hansrune/KiCad-lib-ESP32/README.md

# KiCad-lib-ESP32
KiCad library for ESP32 PCBs
