hansrune/KiCad-lib-ESP32/3D/XIAO-ESP32-mod.step

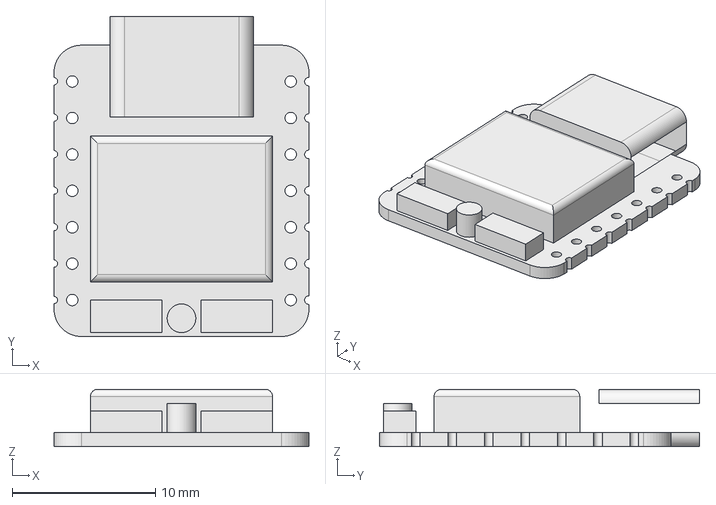
[picture p3: CAD file, 2024-09-19]
3D/XIAO-ESP32-mod.step
17.8 x 22.3 x 4.00 mm
