hansrune/KiCad-lib-ESP32/3D/XIAO_ESP32C3.step

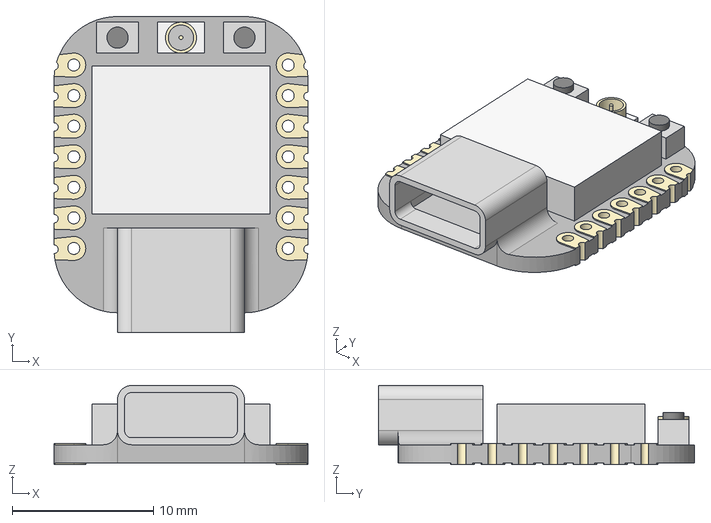
[picture p4: CAD file, 2024-06-03]
3D/XIAO_ESP32C3.step
18.0 x 22.4 x 5.60 mm
