hansrune/KiCad-lib-ESP32/3D/DCDC_01.step

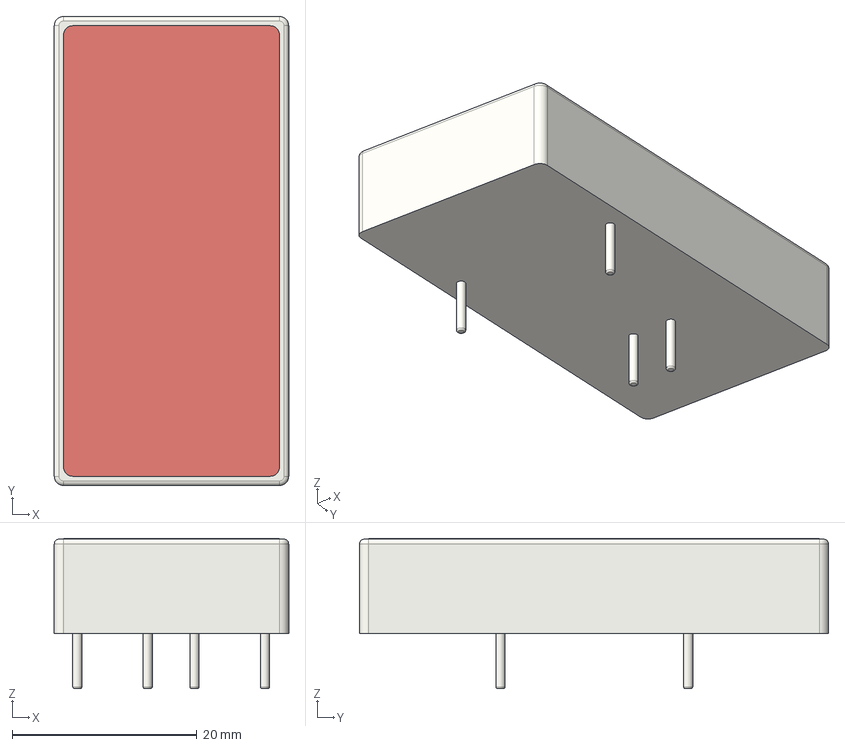
[picture p5: CAD file, 2024-06-03]
3D/DCDC_01.step
25.4 x 50.8 x 16.3 mm
