hansrune/KiCad-lib-ESP32/(list of files, cad)

Other CAD files:
3D/XIAO_ESP32C3_simple.step
