hansrune/KiCad-lib-ESP32/(commit log)

2024-09-16 Added simple 3D file for XIAO ESP32
    [XIAO_ESP32C3_simple.step]
2024-09-19 Added simpler 3D model for XIAO ESP32
    [XIAO-ESP32-mod.step]
2025-09-30 Add from https://github.com/Seeed-Studio/OPL_Kicad_Library
    [SeedStudio-XIAO-ESP32-C3.step, SeedStudio-XIAO-ESP32-C6.step]
2025-09-30 ESP32 C6 missing DIP
2025-10-20 Add 3D model for XIAO-ESP32-C6
2025-10-26 Added combined C3/C6 module footprint
